Target-Formation-Emulator-Senior-Design/Hardware_TFE/README.md

# Hardware_TFE
KiCAD PCB and System Case Design
