Target-Formation-Emulator-Senior-Design/Hardware_TFE/TFE_MechSchematics.pdf

# TFE Mechanical Schematics

## Table of Contents

# RPi4mB

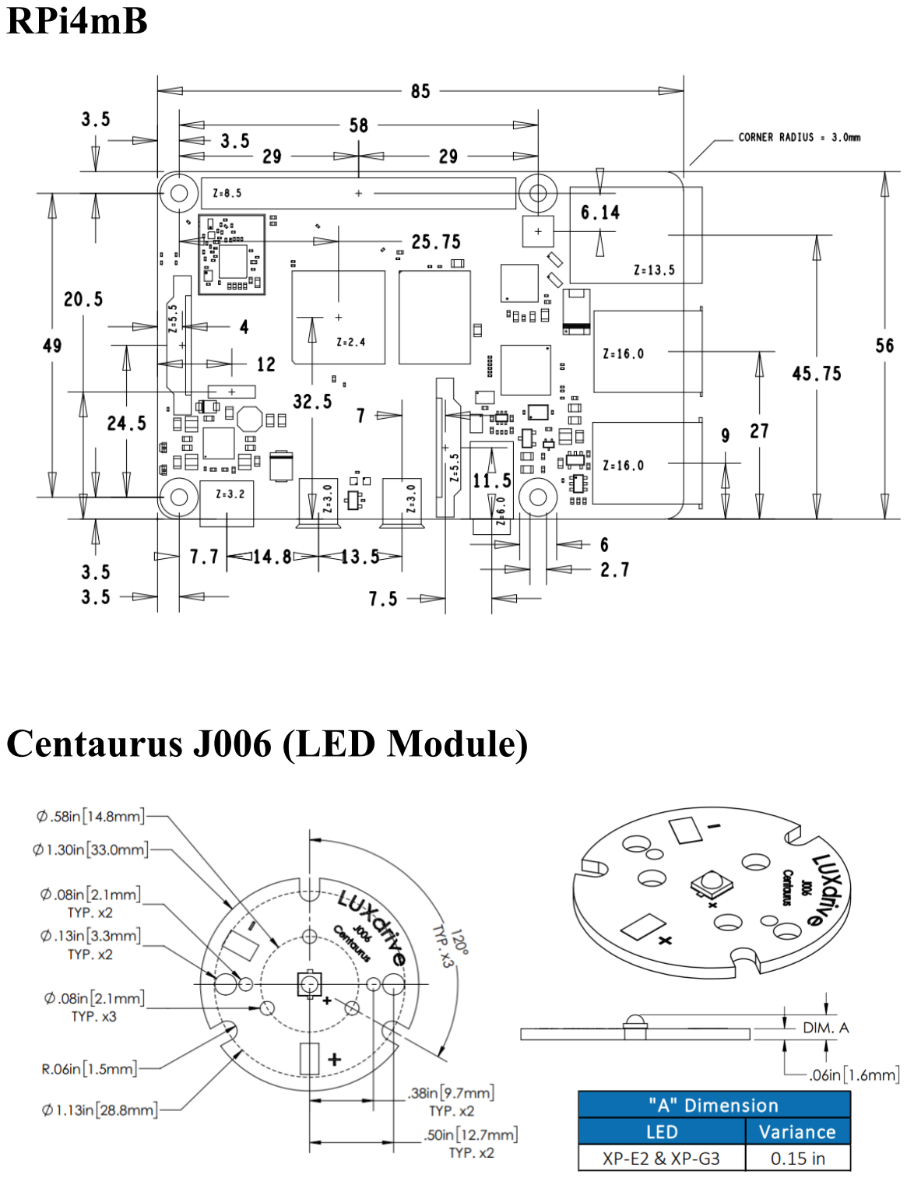
[picture p1: page 2]

# Centaurus J006 (LED Module)

# DHT-22

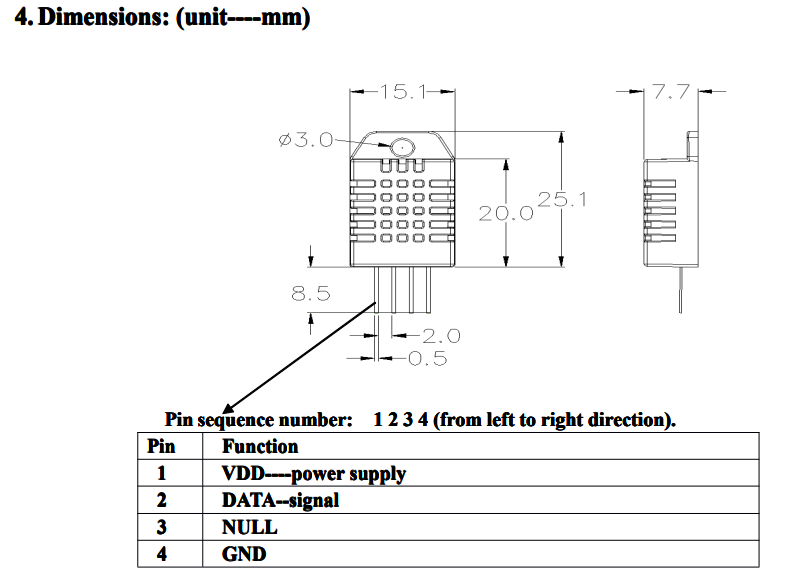
[picture p2: figure]

# AVT Prosilica GC-1290 (Camera)

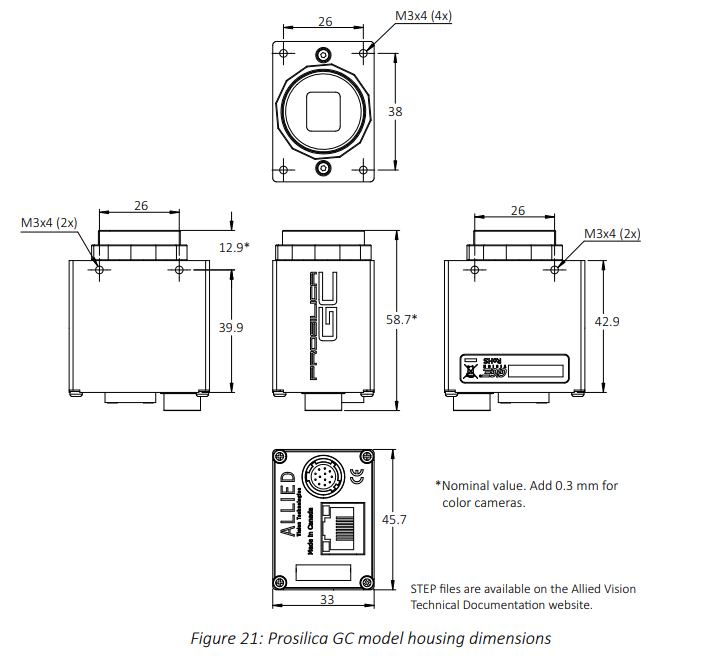
[picture p3: figure]

# Tripod: Allied Vision 02-5002A

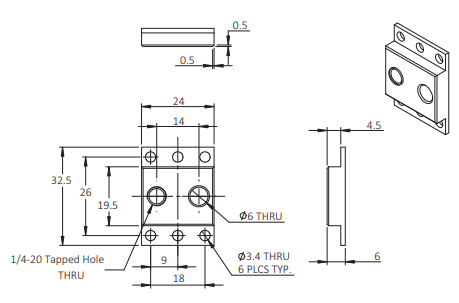
[picture p4: figure]

# LCD

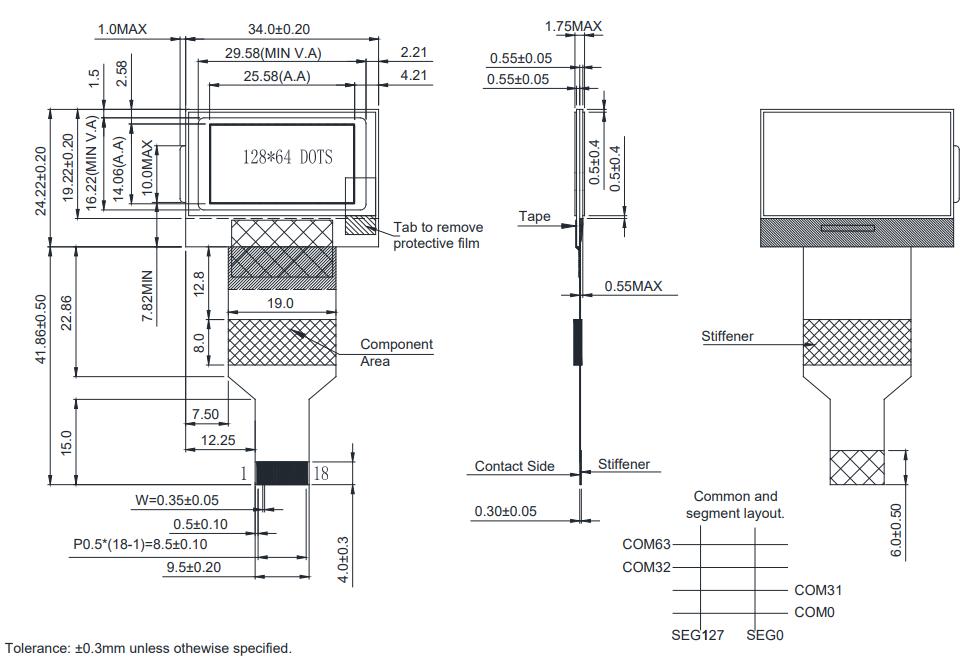
[picture p5: figure]

# LCD Breakout Board

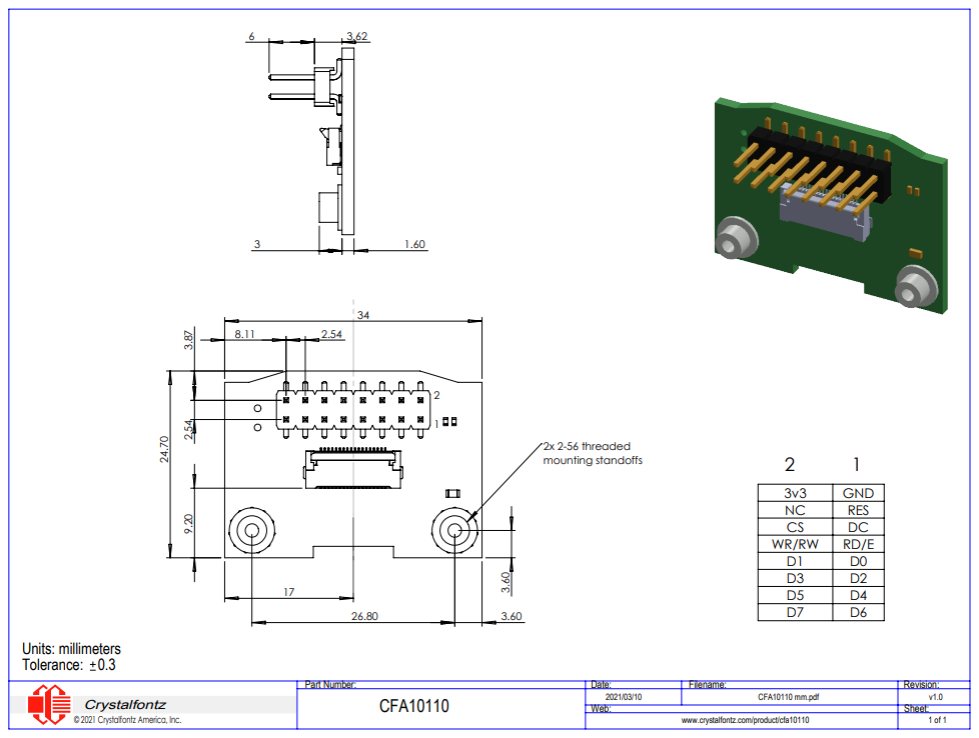
[picture p6: figure]

# Baumer HXG20NIR (ASML’s Camera)

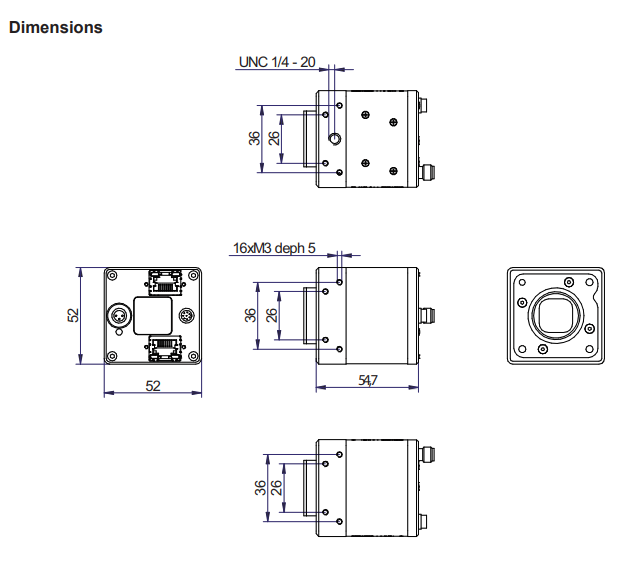
[picture p7: figure]

# Baumer Tripod

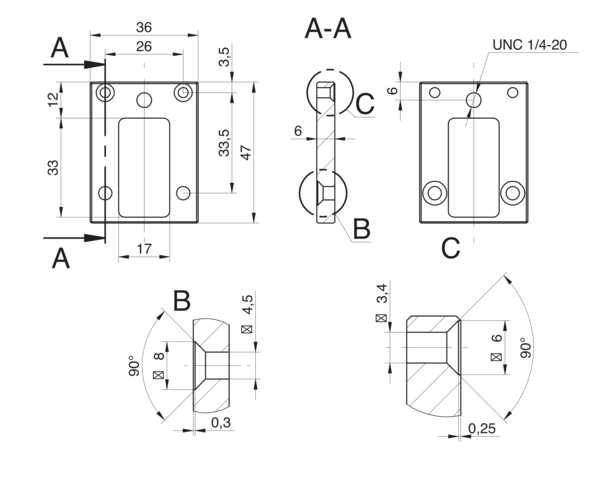
[picture p8: figure]

Missing:
- PCB Dimensions
- Camera working distance

Considerations:
- How will we prop up the LEDs and LCD?
- Looking for very specific universal L brackets… ●
