Target-Formation-Emulator-Senior-Design/Hardware_TFE/24v to 5v v1.3.kicad_pcb

## KiCad design 24v to 5v v1.3.kicad_pcb (2023-11-17)

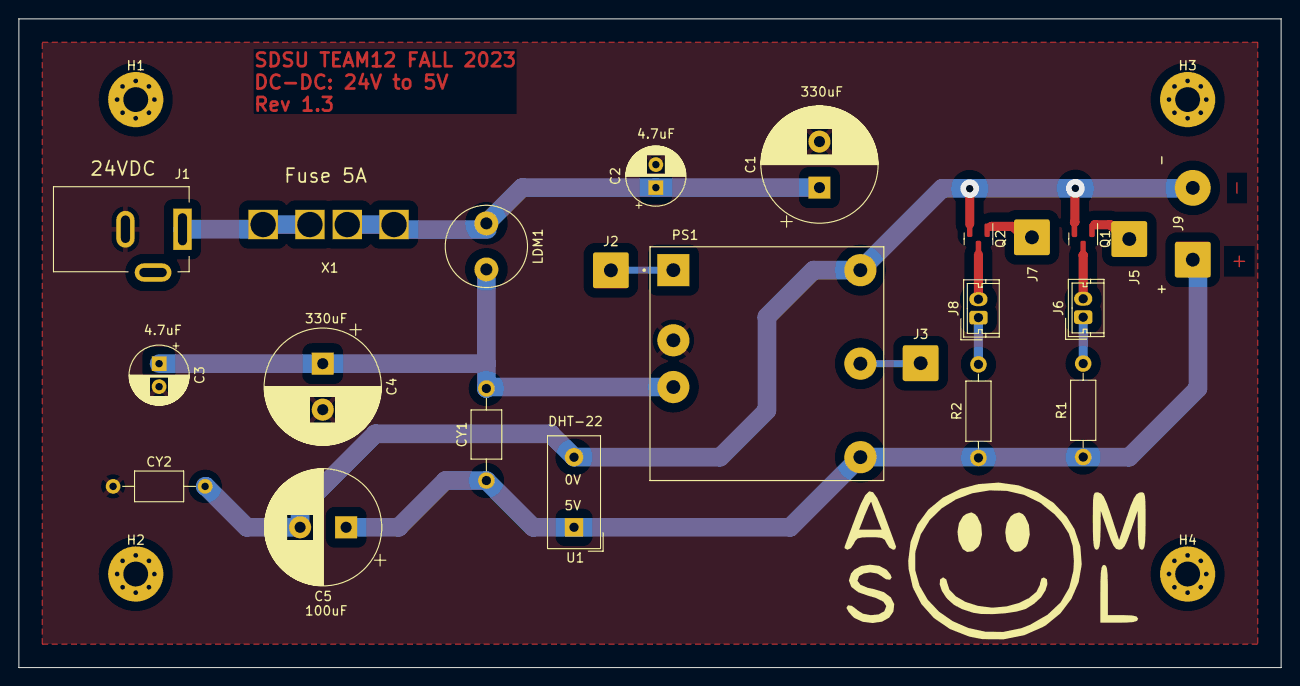
[picture p9: board 24v to 5v v1.3.kicad_pcb from above]

Board: 2 copper layers, 137.2 x 70.5 mm, 27 parts (0 on the bottom side), 14 nets.

Parts:
C1, C4: 330u; CP_Radial_D12.5mm_P5.00mm
C2, C3: 4.7u; CP_Radial_D6.3mm_P2.50mm
C5: 100u; CP_Radial_D12.5mm_P5.00mm
CY1, CY2: 1n; C_Axial_L5.1mm_D3.1mm_P10.00mm_Horizontal
H1, H2, H3, H4: MountingHole; MountingHole_2.7mm_Pad_Via
J1: Conn_01x01; BarrelJack_Kycon_KLDX-0202-xC_Horizontal
J2, J3, J5, J7: Conn_01x01; SolderWire-2sqmm_1x01_D2mm_OD3.9mm
J6, J8: Conn_01x02; Molex_Micro-Latch_53253-0270_1x02_P2.00mm_Vertical
J9: Conn_01x01; SolderWire-2sqmm_1x02_P7.8mm_D2mm_OD3.9mm
LDM1: 2.2u; L_Radial_D8.7mm_P5.00mm_Fastron_07HCP
PS1: PDQE20-Q24-S5-D; CONV_PDQE20-Q24-S5-D
Q1, Q2: NMOS; SOT-23
R1, R2: 5.6; R_Axial_DIN0207_L6.3mm_D2.5mm_P10.16mm_Horizontal
U1: DHT22; Aosong_DHT11_5.5x12.0_P2.54mm
X1: 3522-2; FUSE_3522-2

Connections:
/5V: C5.1, CY1.1, J9.1, PS1.4 (+VO), R1.1, R2.1, U1.1 (VCC)
/24V: J1.1, X1.2A, X1.2B
GND: C1.2, C2.2, C3.2, C4.2, CY2.1, J1.2, PS1.2 (GND)
unnamed: C1.1, C2.1, LDM1.1, X1.1A, X1.1B
unnamed: J2.1, PS1.1 (CTRL)
unnamed: J3.1, PS1.5 (TRIM)
unnamed: J5.1, Q1.1 (D)
unnamed: J6.1, R1.2
unnamed: J6.2, Q1.3 (S)
unnamed: J7.1, Q2.1 (D)
unnamed: J8.1, R2.2
unnamed: J8.2, Q2.3 (S)
unnamed: C5.2, CY2.2, J9.2, PS1.6 (0V), Q1.2 (G), Q2.2 (G), U1.4 (GND)
unnamed: C3.1, C4.1, CY1.2, LDM1.2, PS1.3 (VIN)
