Target-Formation-Emulator-Senior-Design/Hardware_TFE/(commit log)

2023-09-15 KiCAD Schematic 24V buck converter
    24Vin to 5V@3A and 5V@2A. This schematic is not complete.
    [24V buck converter dual output V2.kicad_sch]
2023-09-22 24V to 5V 4A single output CUI switch
    Need footprints for caps, inductor, connectors etc
    [24V buck converter V4.kicad_sch]
2023-09-22 24V buck converter CUI switch
    Needs footprint for pcb portion. Updated input VCC on DHT22 from power input to input. CHeck on ground coming from 0V output at switcher. Does not pass ERC.
    [24V buck converter V5.kicad_sch]
2023-11-17 24V to 5V KiCAD files version 1.1
    KiCAD files for 24V to 5V buck converter.
    1. Increased trace width edge gap to avoid shorts.
    2. Larger footprint for fuse
    3. Removed silkscreen outline for 5A fuse, this avoids screen printing on pads
    [24v to 5v oct prototype v1.1.kicad_sch, 24v to 5v v1.1.kicad_pcb]
2023-11-17 24v to 5v v1.3
    Increased LED pad sizes
    Increased both via size to 2.03
    Moved GPIO gate pin to otherside of power trace to avoid signal issues
    Rearranges some silkscreen text
    [24v to 5v v1.3.kicad_pcb, 24v to 5v v1.3.kicad_sch]
2023-12-21 Delete 24v to 5v oct prototype v1.1 directory
    Obsolete
    [24v to 5v oct prototype v1.1.kicad_sch, 24v to 5v v1.1.kicad_pcb]
2023-12-21 Delete 24V buck converter V4.kicad_sch
    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
    [24V buck converter V4.kicad_sch]
2023-12-21 Delete 24V buck converter V5.kicad_sch
    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
    [24V buck converter V5.kicad_sch]
2023-12-21 Delete 24V buck converter dual output V2.kicad_sch
    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
    [24V buck converter dual output V2.kicad_sch]
2023-12-21 Delete 24V stepdown circuit.kicad_sch
    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
    [24V stepdown circuit.kicad_sch]
2023-12-21 Delete 24V to 5V stepdown circuit.kicad_pcb
    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
    [24V to 5V stepdown circuit.kicad_pcb]
2023-12-21 Gerber files
    Compressed gerber files from 24V to 5V converter version 1.3
    Generated in KiCAD V7
2023-12-22 TFE Instructions for use
    Instructions for Hardware, Firmware and Software
    Information for capabilities and device use
